GLOXIOU/DMX-Unit-DIY/3D-files/to print/Unite DMX - Assembly.step

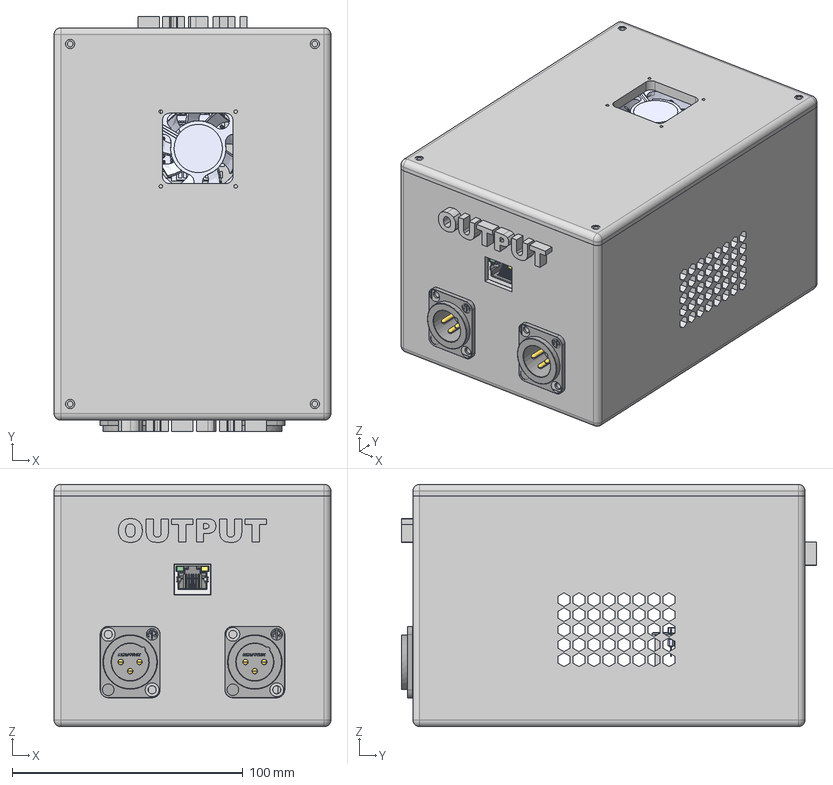
[picture p7: CAD file, 2026-09-11]
3D-files/to print/Unite DMX - Assembly.step
120.0 x 180.0 x 105.0 mm
