GLOXIOU/DMX-Unit-DIY/3D-files/tiny-version/NC3MD-LX_01-GC-STEP.stp

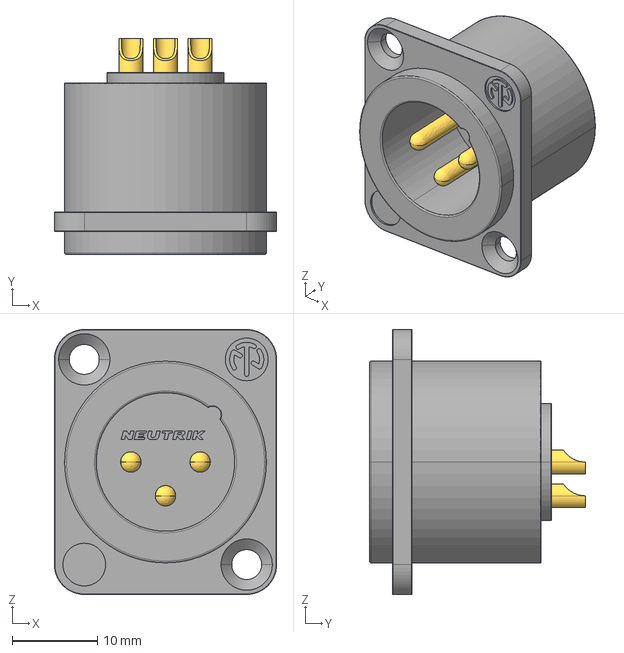
[picture p9: CAD file, 2026-09-11]
3D-files/tiny-version/NC3MD-LX_01-GC-STEP.stp
26.0 x 25.3 x 31.0 mm
