GLOXIOU/DMX-Unit-DIY/3D-files/tiny-version/to print/DMX Unit Tiny - Base.stl

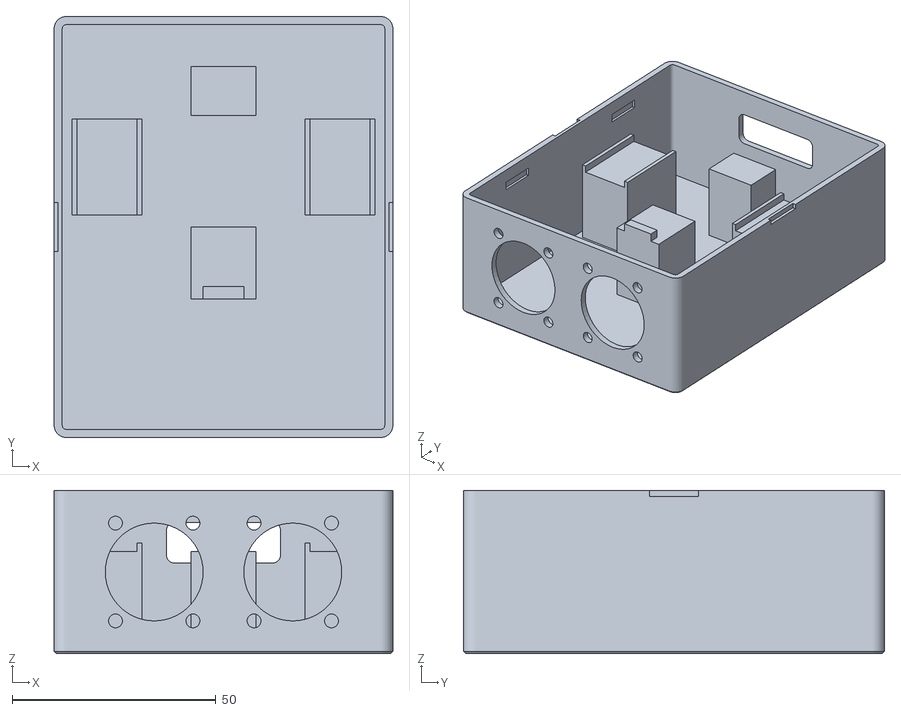
[picture p10: CAD file, 2026-11-05]
3D-files/tiny-version/to print/DMX Unit Tiny - Base.stl
83.1 x 103.3 x 40.0
