GLOXIOU/DMX-Unit-DIY/3D-files/assembly/40x40 Cooling Fan.STEP

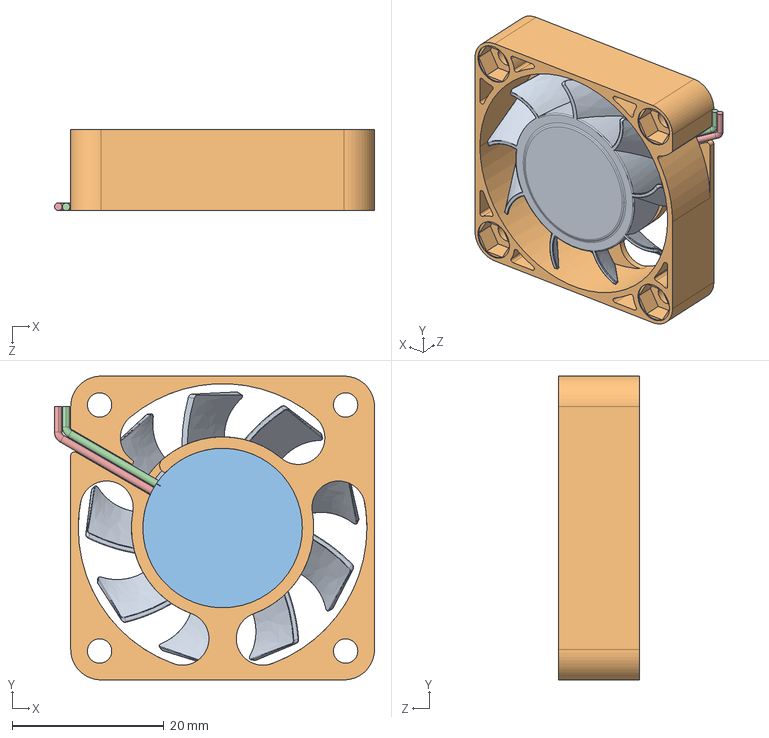
[picture p11: CAD file, 2026-09-11]
3D-files/assembly/40x40 Cooling Fan.STEP
42.1 x 40.0 x 10.7 mm
