GLOXIOU/DMX-Unit-DIY/3D-files/Lite_w5500.step

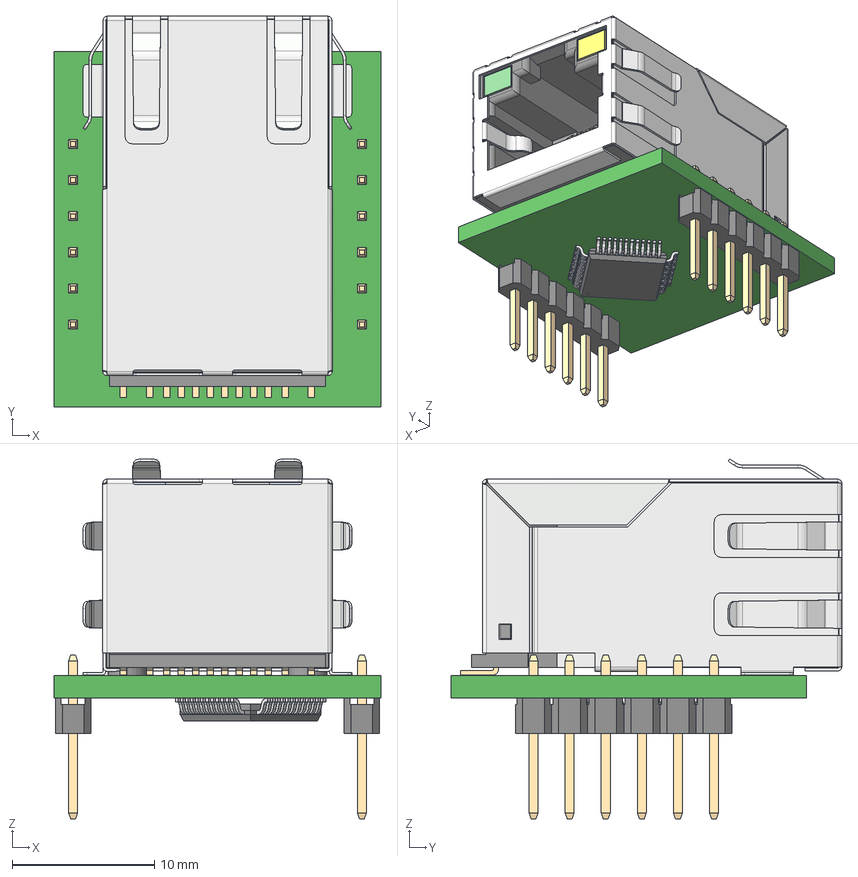
[picture p12: CAD file, 2026-09-11]
3D-files/Lite_w5500.step
23.0 x 27.5 x 25.3 mm
Board
48LQFP_W5500_WIZ
PH1-06-UA x 2
2pin-LED_1_1
P-﹗+L-7Pin-AA
P-﹗+L-5Pin-AA
led1
1X1RJ45-housing_-ｦL｡
