GLOXIOU/DMX-Unit-DIY/3D-files/tiny-version/to print/DMX Unit Tiny - Lid.stl

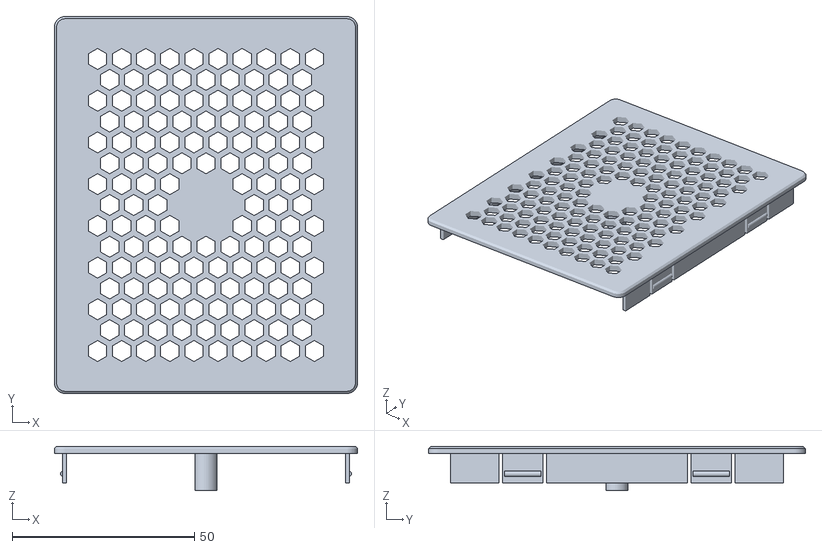
[picture p13: CAD file, 2026-11-05]
3D-files/tiny-version/to print/DMX Unit Tiny - Lid.stl
83.1 x 103.3 x 12.1
