GLOXIOU/DMX-Unit-DIY/3D-files/to print/DMX Unit - V4 - F.stl

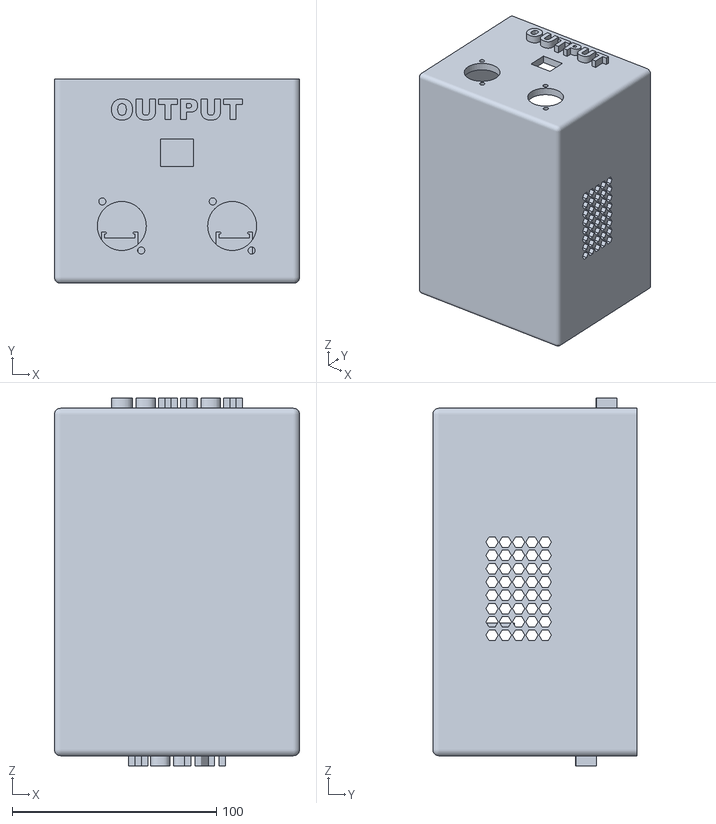
[picture p14: CAD file, 2026-09-11]
3D-files/to print/DMX Unit - V4 - F.stl
120.0 x 100.0 x 180.0
