GLOXIOU/DMX-Unit-DIY/3D-files/to print/DMX Unit - Cover - F.stl

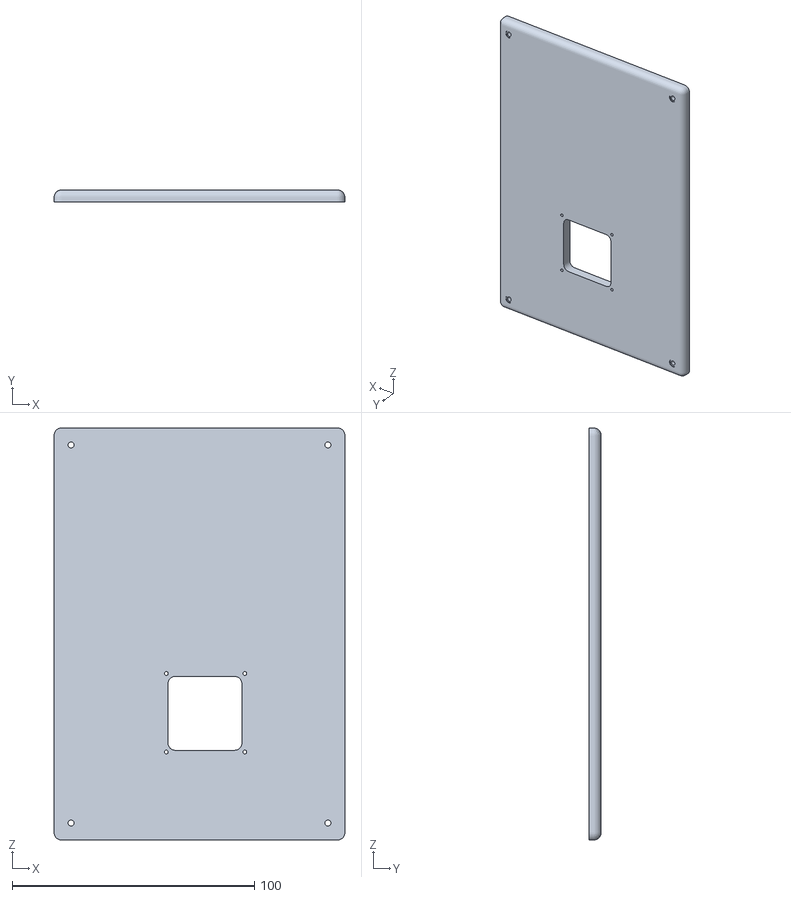
[picture p15: CAD file, 2026-09-11]
3D-files/to print/DMX Unit - Cover - F.stl
120.0 x 5.00 x 170.0
