GLOXIOU/DMX-Unit-DIY/3D-files/DMX Unit - V3.stl

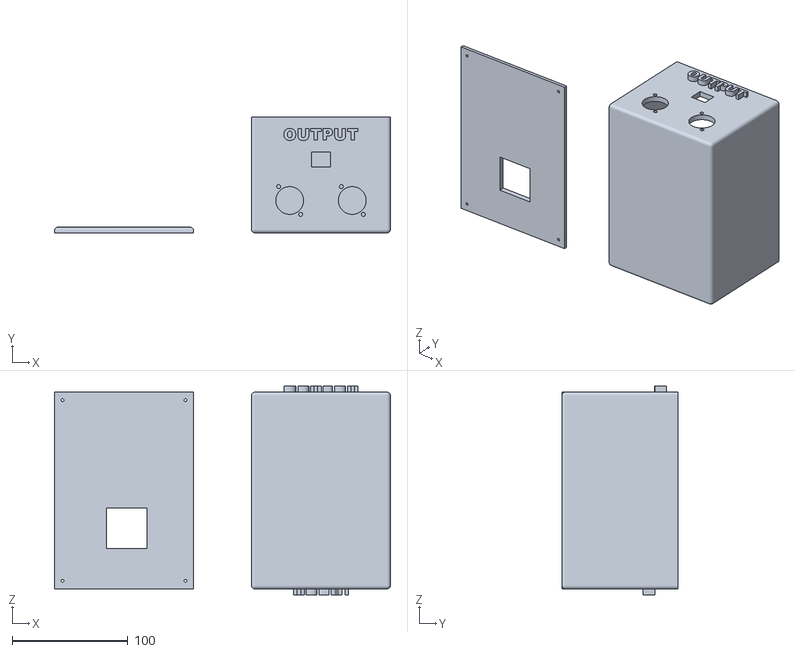
[picture p16: CAD file, 2026-09-11]
3D-files/DMX Unit - V3.stl
290.0 x 100.0 x 180.0
