GLOXIOU/DMX-Unit-DIY/(list of files, cad)

Other CAD files:
3D-files/DMX Unit - V2.stl
3D-files/DMX Unit - Cover.f3d
3D-files/DMX Unit - V1.stl
3D-files/DMX Unit.f3d
3D-files/assembly/DMX Unit up.f3d
3D-files/assembly/DMX Unit.f3d
3D-files/assembly/ass Unite DMX.f3z
3D-files/tiny-version/DMX Unit Tiny.f3d
3D-files/tiny-version/MAX RS 485 module v2.f3d
