GLOXIOU/DMX-Unit-DIY/JOURNAL.md

| title | DMX-Unit-DIY |
| --- | --- |
| author | GLOXIOU |
| description | A DIY project for a DMX controller box that enables stable lighting control via Wi-Fi or USB, featuring both Art-Net and DMX outputs. |
| created_at | 2026-09-08 |

# Day 1: Defining system & idea search & inspiration

I want to make a DMX Box, with WiFi and USB input, and DMX and ArtNet output. All of that in a small box, designed in 3D in Fusion 360. Everything will be managed by an ESP32, and cooled by a 40x40 tiny little fan.

My inspiration is the Enttec Open DMX USB Interface. I want to make that, but for much cheaper, and with more functionality. The only thing I want to keep from that housing is his formfactor, a very small box.

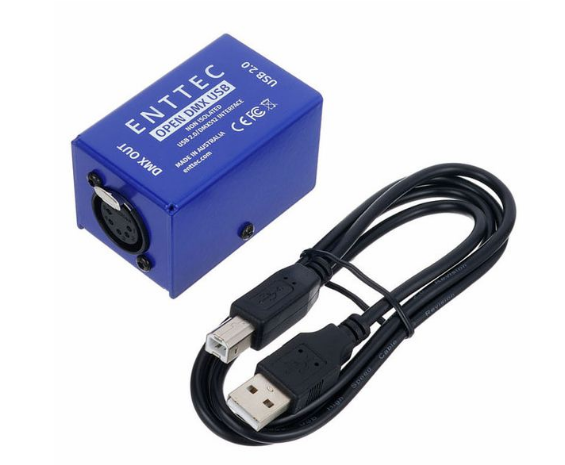
[picture p17: images/img-1.png]


So, here is an initial list of the equipment needed for the project which, of course, is still subject to change:

| Component | Quantity | Price |
| --- | --- | --- |
| [W5500](https://fr.aliexpress.com/item/1005007639330460.html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) | 1 | 6,27$ |
| [MAX485 RS-485 Module](https://fr.aliexpress.com/item/1005007894242423.html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) | 2 | 3,26$ |
| [ESP32-S3](https://fr.aliexpress.com/item/1005008809316571.html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) | 1 | 3,95$ |
| [XLR 3-Pin Panel Mount Female](https://fr.aliexpress.com/item/1005008919369057.html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) | 2 | 4,88$ |
| [12-Hole Bridge](https://fr.aliexpress.com/item/1005006003920533.html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) | 2 | 0,81$x2 |
| [Dupont cables](https://www.aliexpress.com/ssr/300000512/BundleDealsDutyCovered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) | kit | 2,48$ |
| **Total** | | **22,46$** |

I then drew the wiring diagram showing the connections between the components. Here is what I’ve managed to put together, but just like the list of components it’s still subject to change. Here is it:

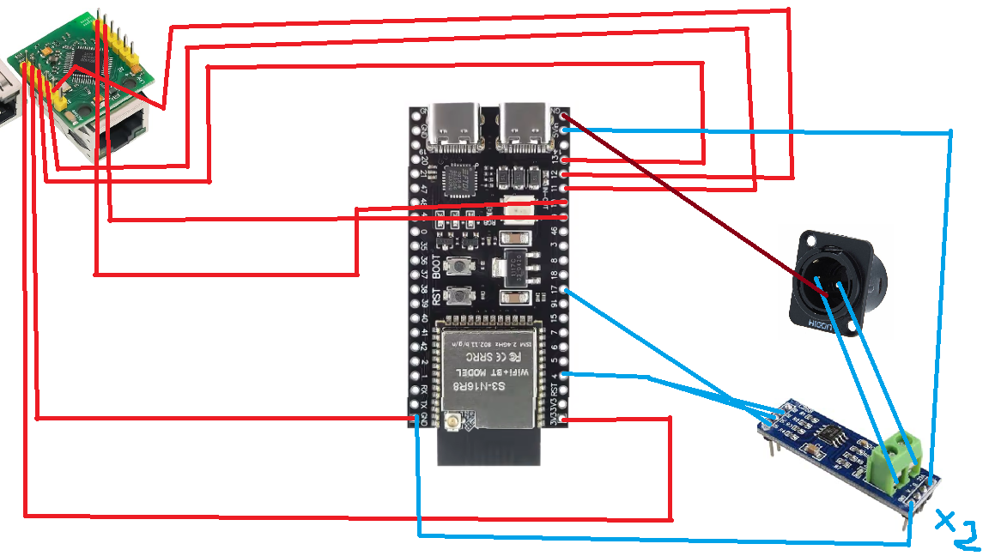
[picture p18: images/schema-1.png]
Schema 1


And the summary table:

**ESP32-S3 (S3-N16R8)**

| ESP32-S3 Pin | Connected Component | Component Pin |
| :--- | :--- | :--- |
| **3V3** | W5500 Mini | 3.3V (J1, Pin 1) |
| **GND** | W5500 Mini / MAX485 #1 / MAX485 #2 / XLR #1 / XLR #2 | GND / Pin 1 (XLR) |
| **5Vin** | MAX485 #1 / MAX485 #2 | VCC |
| **GPIO 4** | MAX485 #1 | DE + RE (tied together) |
| **GPIO 5** | MAX485 #2 | DE + RE (tied together) |
| **GPIO 9** | W5500 Mini | RST (J2, Pin 2) |
| **GPIO 10** | W5500 Mini | SCS / CS (J2, Pin 1) |
| **GPIO 11** | W5500 Mini | MOSI (J1, Pin 4) |
| **GPIO 12** | W5500 Mini | SCLK (J1, Pin 5) |
| **GPIO 13** | W5500 Mini | MISO (J1, Pin 3) |
| **GPIO 17** | MAX485 #1 | DI |
| **GPIO 18** | MAX485 #2 | DI |

**W5500 Mini (Top view, RJ45 facing down)**

| Row | Pin | Signal | ESP32-S3 Connection |
| :--- | :--- | :--- | :--- |
| **Left (J1)** | 1 (Top) | **3.3V** | **3V3** |
| **Left (J1)** | 2 | **GND** | **GND** |
| **Left (J1)** | 3 | **MISO** | **GPIO 13** |
| **Left (J1)** | 4 | **MOSI** | **GPIO 11** |
| **Left (J1)** | 5 (Bottom) | **SCLK** | **GPIO 12** |
| **Right (J2)** | 1 (Top) | **SCS** | **GPIO 10** |
| **Right (J2)** | 2 | **RST** | **GPIO 9** |
| **Right (J2)** | 3 | **INT** | *Not connected* |
| **Right (J2)** | 4 | **NC** | *Not connected* |
| **Right (J2)** | 5 (Bottom) | **NC** | *Not connected* |

**MAX485 Module #1 (DMX Universe 1)**

| MAX485 #1 Pin | Connection |
| :--- | :--- |
| **VCC** | **5Vin** (ESP32-S3) |
| **GND** | **GND** (ESP32-S3) + Pin 1 (XLR #1) |
| **DI** | **GPIO 17** (ESP32-S3) |
| **RO** | *Not connected* |
| **DE** | **GPIO 4** (ESP32-S3) |
| **RE** | **GPIO 4** (ESP32-S3, tied with DE) |
| **A** | Pin 3 / DMX+ (XLR #1) |
| **B** | Pin 2 / DMX- (XLR #1) |

**MAX485 Module #2 (DMX Universe 2)**

| MAX485 #2 Pin | Connection |
| :--- | :--- |
| **VCC** | **5Vin** (ESP32-S3) |
| **GND** | **GND** (ESP32-S3) + Pin 1 (XLR #2) |
| **DI** | **GPIO 18** (ESP32-S3) |
| **RO** | *Not connected* |
| **DE** | **GPIO 5** (ESP32-S3) |
| **RE** | **GPIO 5** (ESP32-S3, tied with DE) |
| **A** | Pin 3 / DMX+ (XLR #2) |
| **B** | Pin 2 / DMX- (XLR #2) |

**3-Pin XLR Connectors**

| XLR Connector | XLR Pin | Connection |
| :--- | :--- | :--- |
| **XLR #1 (Universe 1)** | Pin 1 (Shield) | **GND** |
| **XLR #1 (Universe 1)** | Pin 2 (Data -) | **B** (MAX485 #1) |
| **XLR #1 (Universe 1)** | Pin 3 (Data +) | **A** (MAX485 #1) |
| **XLR #2 (Universe 2)** | Pin 1 (Shield) | **GND** |
| **XLR #2 (Universe 2)** | Pin 2 (Data -) | **B** (MAX485 #2) |
| **XLR #2 (Universe 2)** | Pin 3 (Data +) | **A** (MAX485 #2) |

**Total time spent: 3 hours**

# Day 2: 3D conception and other stuff

I want to make a small box, the smalest possible with all of the componment. That box will be print in PLA, on a Bambulab A1. So the maximum size is 25,6cm by 25,6cm. This enclosure must therefore house a small 40x40mm fan, two XLR ports and the necessary circuitry to operate them, an Art-Net port and the necessary circuitry to operate it, as well as a USB-C port—already integrated into the ESP32, which must also be inside the enclosure.

I'm now making the box on Fusion 360, with the dimension of the componment. Here's what it's look like: (You can check the V1 file [just here](3D-files/DMX%20Unit%20-%20V1.stl).)

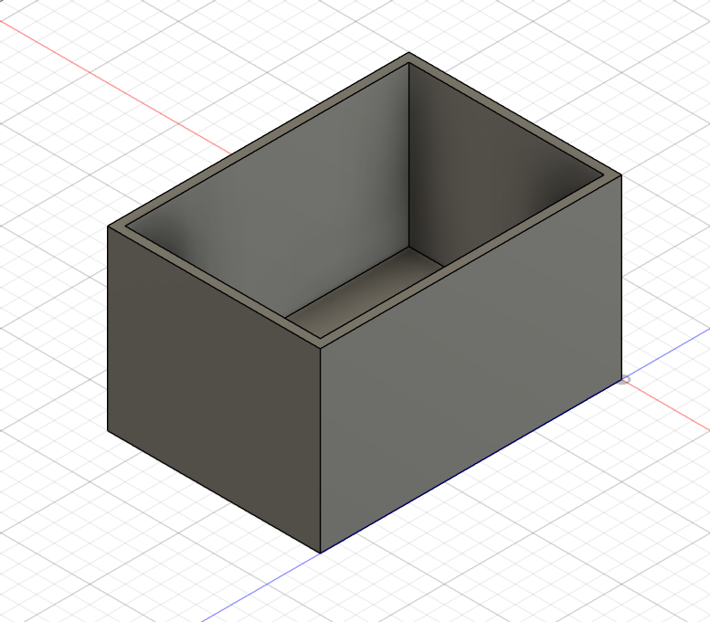
[picture p19: images/img-2.png]
First version


An XLR connector is 1.6 cm wide. We have 2, and between those two centres, there is a 6 cm gap . On top of that, there is a 3 cm gap  between the outer edges (right and left) and the centres of the XLR connectors. Adding all that up, you end up with a box that is 12 cm wide . It fits on the Bambu Lab A1 build plate.

As for the length, the ESP-32 is 5,5cm long, and the MAX485 is 4,5. The Ethernet module is litlle, and don't need to be add to the calculation. But, there's the the length of the XLR connectors, and the addition of extra space to make assembly easier. So the box will be 17cm.

Regarding the height of the box, the main consideration is ease of construction. The box will therefore be 10 cm high.

So, to sum up, the box measures 12x17x10. It fits perfectly on the Bambu Lab A1 build plate! I think I'm going to spend a lot of time on 3D, simply because I'm just starting out with modeling.

Regarding airflow, I decided to mount the 40x40mm fan inside the enclosure—on the lid, directly above the ESP-32—to improve cooling and save space. Near the bottom, along the two 17cm-long sides, there will be a grille of some sort to allow air to exit the box. Even though hot air rises, my experience has taught me that it is better to direct the airflow straight onto the ESP to cool it down.

To close the box, I am going to install heat-set threaded inserts that will allow the lid to be screwed on.

Here is a list of items to buy for the box, other than the electronic components:

| Components | Quantity | Price |
| --- | --- | --- |
| [heat-set threaded inserts](https://fr.aliexpress.com/item/1005007640664497.html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) | 4 | 1,86$ |
| [M2 metric screws](https://fr.aliexpress.com/item/32810852732.html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) | 4 | 1,54$ |
| [40x40mm fan](https://fr.aliexpress.com/item/1005006212685458.html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) | 1 | 3,21$ |
| [2N2222 Transistor](https://fr.aliexpress.com/item/1005010473134376.html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) | 1 | 1,55$ |
| [1 kΩ resistor](https://fr.aliexpress.com/item/1005007010335100.html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) | 1 | 1,59$ |

To run the fan, you need to add a 2N2222 transistor and a 1 kΩ resistor. So, I need to updated the ESP-32 wiring diagram with all that. I also need to changes the 3D model, with the cover and all the wholes.

**Total time spent: 3.5 hours**

# Day 3: Continue the 3D model and the ESP-32 wiring diagram

I started by updating the 3D model: (You can check the V2 file [just here](3D-files/DMX%20Unit%20-%20V2.stl).)

Here are the cotations for the output pannel, in the front of the box:

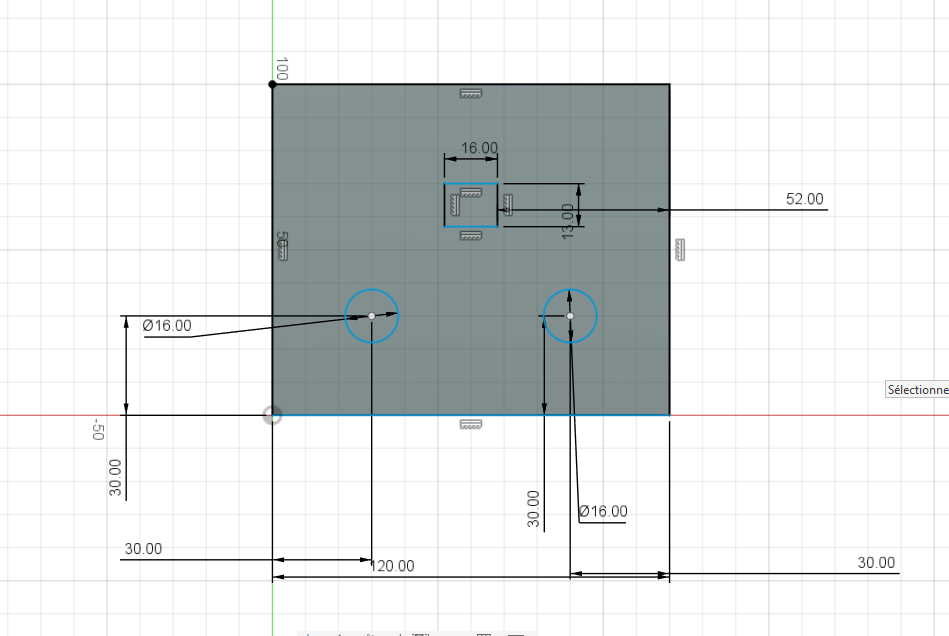
[picture p20: images/img-4.png]


And it's 3D version (with a litlle text):

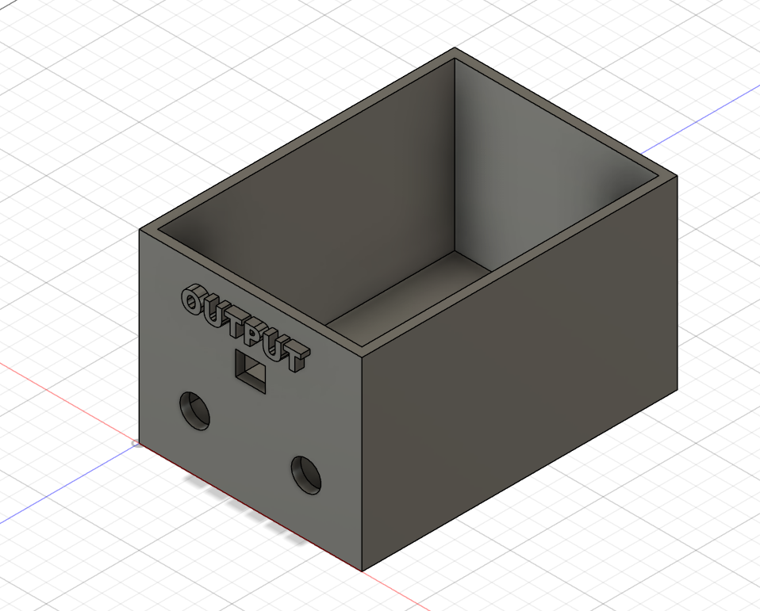
[picture p21: images/img-5.png]


That is the back pannel, with just the hole for the ESP32-S3 (I made it generously sized for ease of use):

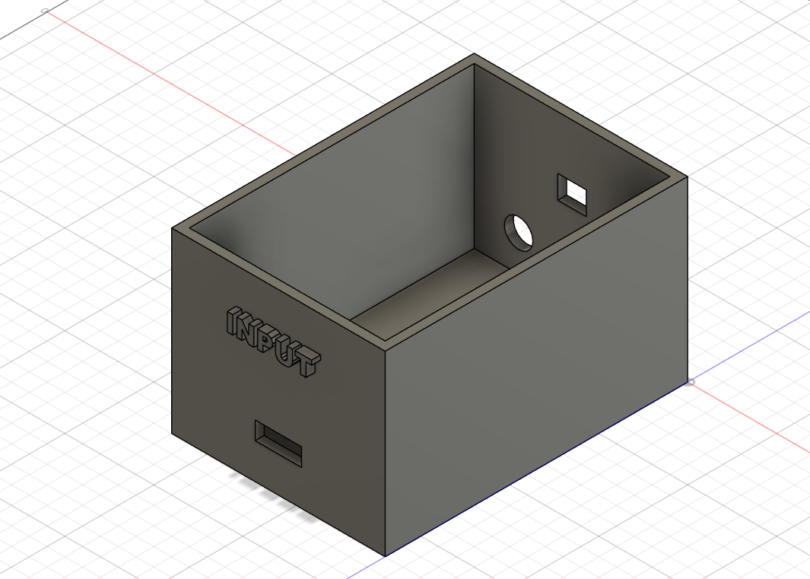
[picture p22: images/img-6.png]
Back pannel


I’ve also made a lid. All that’s left is to make the mounts for the components and the lid itself. I also need to make the ventilation grilles on both sides, but that's very simple to do. I apologize for the quality of the 3D models, I hate modeling, so I kept it as simple as possible so I could spend time on what I enjoy more !

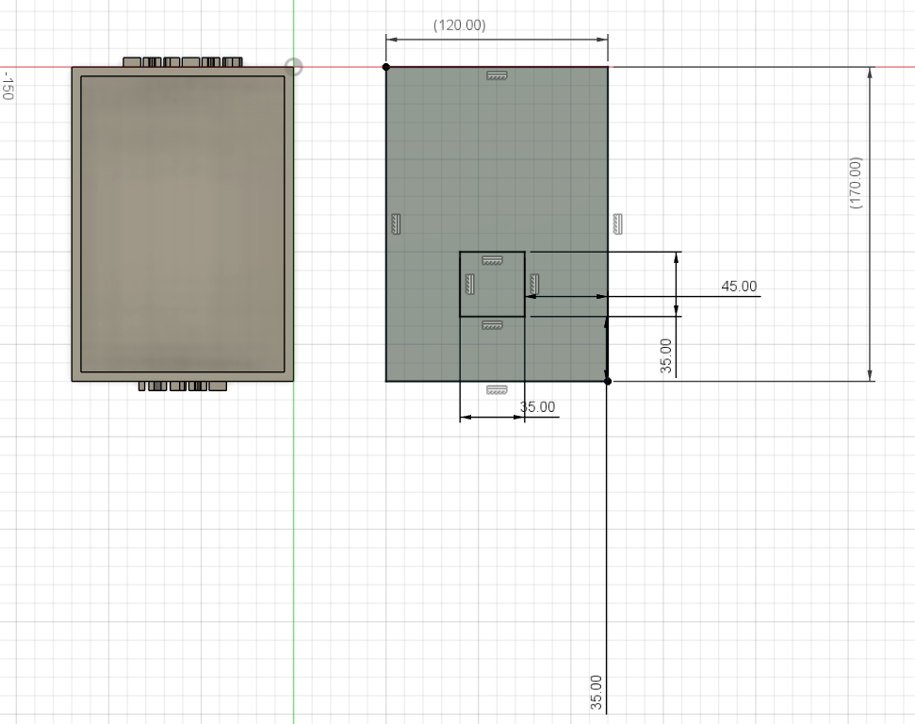
[picture p23: images/img-7.png]
The lid


To secure the components, I would use cable ties with the mounts I've made, and for the fan, glue will do the trick.

And the I finished the wiring diagram, wich normally is the final version:

Final schema

Please excuse the state of the wiring diagram. I had to create it on an iPad, which isn't very convenient. That’s why I’m making a connection chart to help me keep track of things when assembling the components. So I also updated the connection chart, so here is it:

ESP32-S3 (S3-N16R8)

ESP32-S3 Pin | Connected Component | Component Pin
--- | --- | ---
3V3 | W5500 Mini | 3.3V (J1, Pin 1)
GND | W5500 Mini / MAX485 #1 / MAX485 #2 / XLR #1 / XLR #2 / 2N2222 | GND / Pin 1 (XLR) / Emitter
5Vin | MAX485 #1 / MAX485 #2 / Fan | VCC / VCC / Fan +
GPIO 4 | MAX485 #1 | DE + RE (tied together)
GPIO 5 | MAX485 #2 | DE + RE (tied together)
GPIO 6 | Fan circuit | 1kΩ resistor → Base 2N2222
GPIO 9 | W5500 Mini | RST (J2, Pin 2)
GPIO 10 | W5500 Mini | SCS / CS (J2, Pin 1)
GPIO 11 | W5500 Mini | MOSI (J1, Pin 4)
GPIO 12 | W5500 Mini | SCLK (J1, Pin 5)
GPIO 13 | W5500 Mini | MISO (J1, Pin 3)
GPIO 17 | MAX485 #1 | DI
GPIO 18 | MAX485 #2 | DI

W5500 Mini (Top view, RJ45 facing down)

Row | Pin | Signal | ESP32-S3 Connection
--- | --- | --- | ---
Left (J1) | 1 (Top) | 3.3V | 3V3
Left (J1) | 2 | GND | GND
Left (J1) | 3 | MISO | GPIO 13
Left (J1) | 4 | MOSI | GPIO 11
Left (J1) | 5 (Bottom) | SCLK | GPIO 12
Right (J2) | 1 (Top) | SCS | GPIO 10
Right (J2) | 2 | RST | GPIO 9
Right (J2) | 3 | INT | Not connected
Right (J2) | 4 | NC | Not connected
Right (J2) | 5 (Bottom) | NC | Not connected

MAX485 Module #1 (DMX Universe 1)

MAX485 #1 Pin | Connection
--- | ---
VCC | 5Vin (ESP32-S3)
GND | GND (ESP32-S3) + Pin 1 (XLR #1)
DI | GPIO 17 (ESP32-S3)
RO | Not connected
DE | GPIO 4 (ESP32-S3)
RE | GPIO 4 (ESP32-S3, tied with DE)
A | Pin 3 / DMX+ (XLR #1)
B | Pin 2 / DMX- (XLR #1)

MAX485 Module #2 (DMX Universe 2)

MAX485 #2 Pin | Connection
--- | ---
VCC | 5Vin (ESP32-S3)
GND | GND (ESP32-S3) + Pin 1 (XLR #2)
DI | GPIO 18 (ESP32-S3)
RO | Not connected
DE | GPIO 5 (ESP32-S3)
RE | GPIO 5 (ESP32-S3, tied with DE)
A | Pin 3 / DMX+ (XLR #2)
B | Pin 2 / DMX- (XLR #2)

3-Pin XLR Connectors

XLR Connector | XLR Pin | Connection
--- | --- | ---
XLR #1 (Universe 1) | Pin 1 (Shield) | GND
XLR #1 (Universe 1) | Pin 2 (Data -) | B (MAX485 #1)
XLR #1 (Universe 1) | Pin 3 (Data +) | A (MAX485 #1)
XLR #2 (Universe 2) | Pin 1 (Shield) | GND
XLR #2 (Universe 2) | Pin 2 (Data -) | B (MAX485 #2)
XLR #2 (Universe 2) | Pin 3 (Data +) | A (MAX485 #2)

Fan 40x40mm

| Fan Pin | Connection | 
| --- | --- |
| + | 5Vin (ESP32-S3) |
| - | Collector (2N2222) |

2N2222

2N2222 Pin | Connection
--- | ---
Base | GPIO 6 through 1kΩ resistor
Collector | Fan -
Emitter | GND

The RJ45 connector is tricky because, since it's the mini version, the port labels aren't printed on the PCB. So, I asked an LLM about the pinout.

Now that I've done that, all that's left is to finish the 3D model, write the full code, and create the readme. I think the modeling will take the longest. I also need to put together the complete BOM, including all prices and links.

**Total time spent: 5 hours**

# Day 4: 3D modeling, again...

I started by making the edge of the box curved, beacause aparently it's a requirment in HackClub, so here it is:

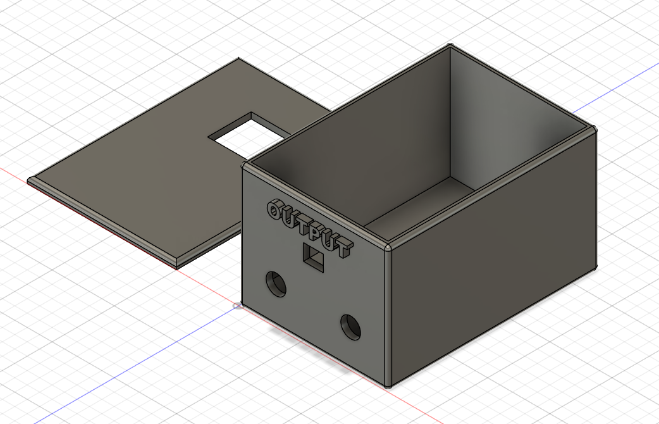
[picture p24: images/img-8.png]
Curved edge


And, like other days, you can check the V3 file [just here](3D-files/DMX%20Unit%20-%20V3.stl).

Then I realized I'd made a mistake with the XLR output size. So I drilled another hole fot that, and for the screws.

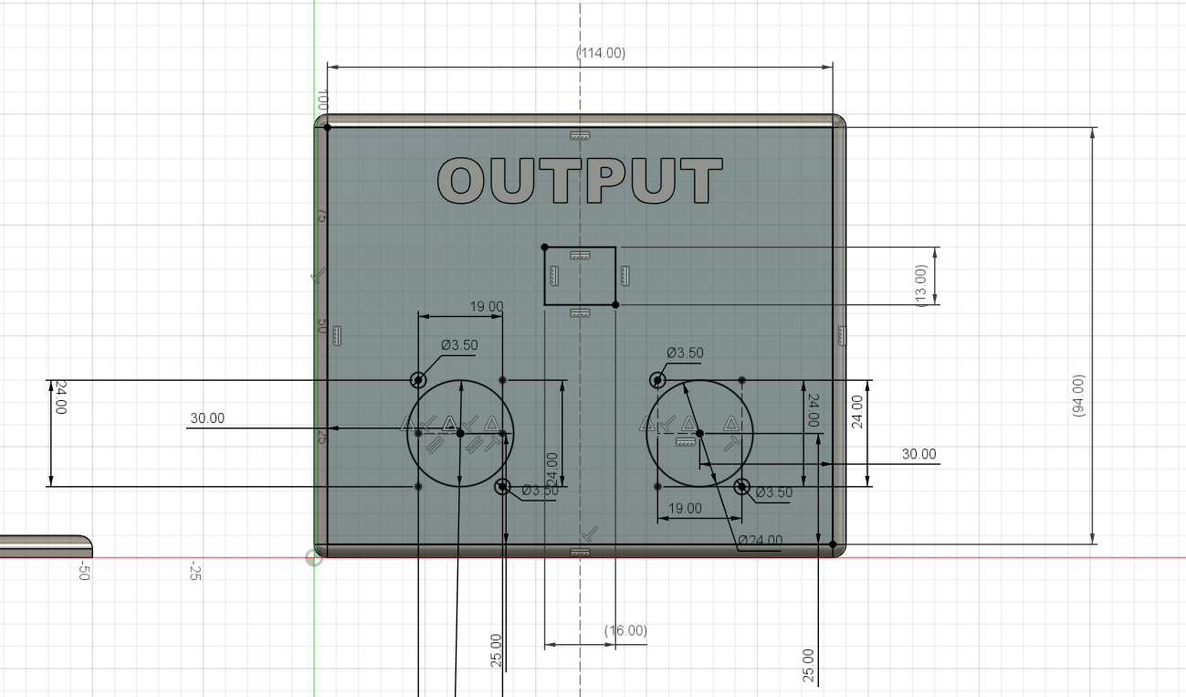
[picture p25: images/img-9.png]
XLR Hole

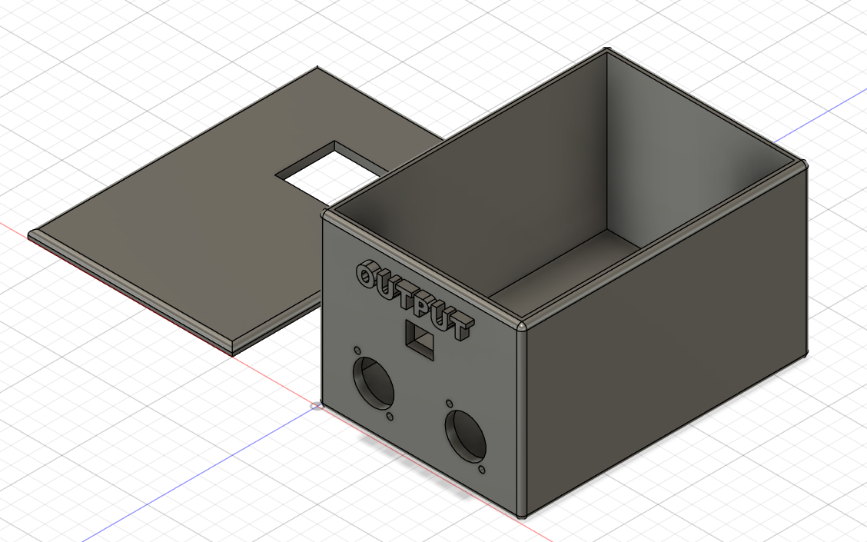
[picture p26: images/img-10.png]
The 3D version


After that, I made the supports and the woles for the cover of the box. All that remains are the mounts for the components !

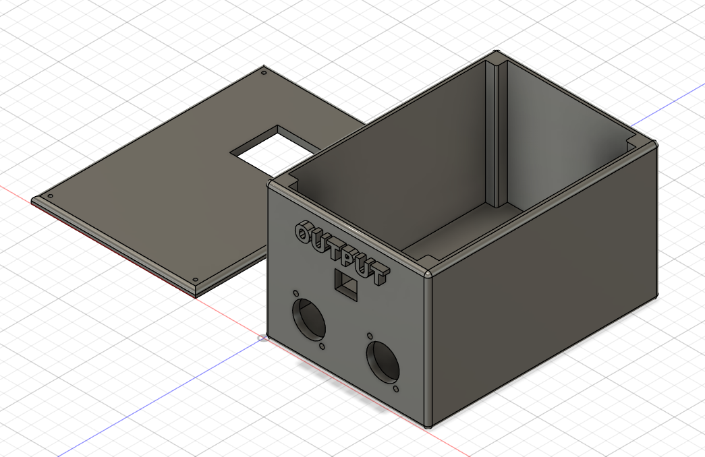
[picture p27: images/img-11.png]
Woles for the cover


When I come back this afternoon, I search all the components on [grabcad](grabcad.com), download it, place it. You can check all the models I dowload in [this folder](3D-files/).

And I made the support for the components. I also delete the curve edge that I made on the top of the box, beacause thre is already one on the cover. The componment are also integreted, the assembly is also complete. So here's how the 3D model look so far:

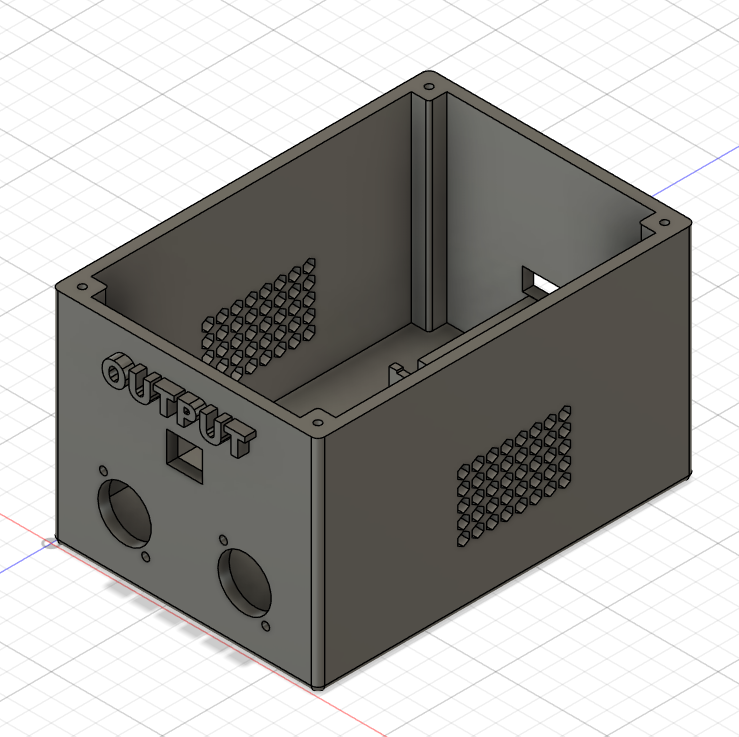
[picture p28: images/img-12.png]
Final look


And there is the final 3D file [just here](3D-files/DMX%20Unit%20-%20V4%20-%20F.stl) !

Here are several screenshots of the model and the assembly:


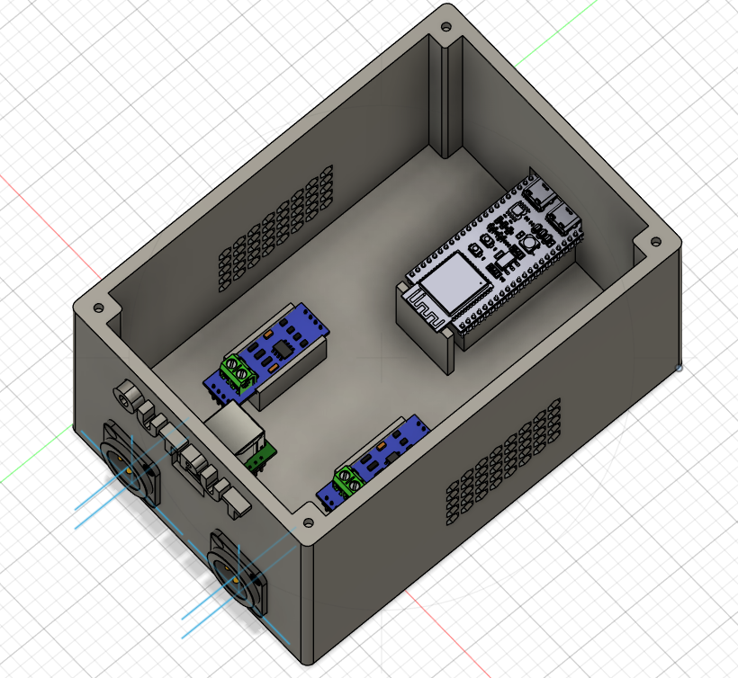
[picture p29: images/img-14.png]



You can check all the final stl 3D files in [this folder](3D-files/to%20print/); the assembly files in [that folder](3D-files/assembly/) and the ultimate step assembly file [just here](3D-files/assembly/Unite%20DMX%20-%20Assembly.step)

Today was so much modeling, and I learn so much things ! To sum up, all the mounts are done including the one for the cover the components are in the right places, and the airflow is optimized. I think the case is really great !

**Total time spent: 5 hours**

# Day 5: BOM and begening of the code

I started the day by doing the BOM of the project using the tables I had already made on previous days: (You can check the CSV file [here](BOM.csv))

| Component | Quantity | Price |
| --- | ---: | ---: |
| [W5500](https://fr.aliexpress.com/item/1005007639330460.html) | 1 | $6.27 |
| [MAX485 RS-485 Module](https://fr.aliexpress.com/item/1005008477779481.html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) | 2 | 2x$1 |
| [ESP32-S3](https://fr.aliexpress.com/item/1005008809316571.html) | 1 | $3.95 |
| [XLR 3-Pin Panel Mount Female](https://fr.aliexpress.com/item/1005008919369057.html) | 2 | $4.88 |
| [Dupont Cables](https://www.aliexpress.com/ssr/300000512/BundleDealsDutyCovered) | 1 kit | $2.48 |
| [Heat-Set Threaded Inserts](https://fr.aliexpress.com/item/1005007640664497.html) | 4 | $1.86 |
| [M2 Metric Screws](https://fr.aliexpress.com/item/32810852732.html) | 4 | $1.54 |
| [40 × 40 mm Fan](https://fr.aliexpress.com/item/1005006212685458.html) | 1 | $3.21 |
| [2N2222 Transistor](https://fr.aliexpress.com/item/1005010473134376.html) | 1 | $1.55 |
| [1 kΩ Resistor](https://fr.aliexpress.com/item/1005007010335100.html) | 1 | $1.59 |
| **Total** | | **$29,33** |

The chart didn't take me a huge amount of time, but I also verified the compatibility of all the components, the circuit diagram, as well as prices, links, quantities, and so on, just to be sure, since the project is nearing completion.

Next, I worked on the firmware. I would say about half the features are ready. It still needs testing, and most importantly, I need to go through this entire list:

* DMX/USB input ("Enttec-like" mode when connecting the ESP32-S3 via USB).
* Wi-Fi mode / configuration portal.
* **ArtPoll** response (the device will not automatically appear in
Art-Net discovery software — the IP address must be entered manually;
`192.168.1.77` by default in this sketch).
* Persistent settings storage (Preferences/EEPROM).
* RDM.

So there's still a little bit of work to do ! You can check the file V1 [just here](firvware%20-%20V1). Here is a look at the code:

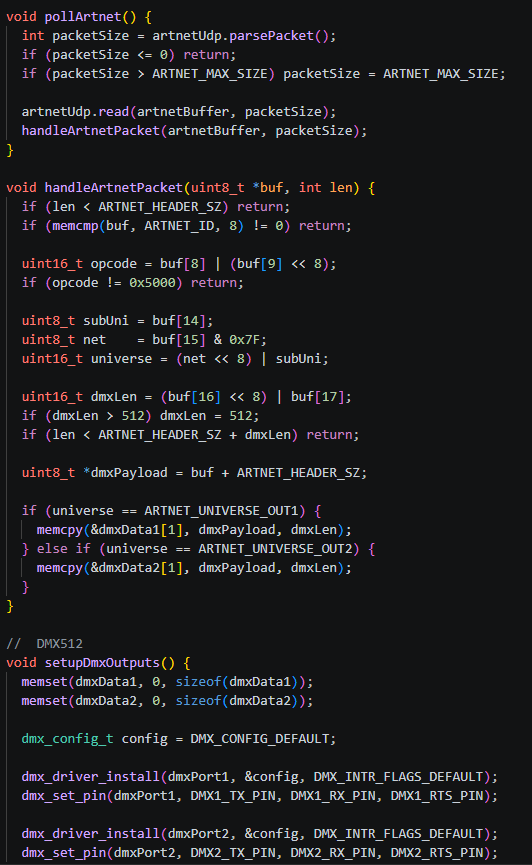
[picture p30: images/img-16.png]
Part of the code


**Total time spent: 3 hours**

# Day 6: Finishing + testing the code

I started the day by finishing writing the intire code. You can see the file [here](firvware%20-%20V2).

Everything that was in the TO-DO list of yesterday is done. All that's left is to test it, even though I don't have the physical hardware to do so. The code is solid, so I'm a bit concerned about stability ! Worst case scenario, I'll modify the code later.

The most time consuming part was building the web interface, as it was my first time creating one for an ESP-32. This interface allows you to:

* Configure network settings, addresses, etc.
* Configure Wi-Fi (SSID and password)
* Set up Art-Net, assign DMX universes, etc.
* Adjust hardware settings, configure the fan, and set up USB or Wi-Fi inputs
* Scan the DMX network and perform RDM detection

If everything works, it’s going to be really great !

However, for the code to work, it is necessary that the "USB CDC On Boot" parameter is enabeld, and that all these libraries be installed:

* esp_dmx by Mitch Weisbrod (in the lastest version)
* Ethernet (arduino-libraries/Ethernet)
* WiFi, WebServer, DNSServer, Preferences (but that come pre-installed on the board, so that's okay)

I haven't compiled the final version of the code yet, so I'm going to do that to see if everything works. To do that, I'm using [wokwi](wokwi.com), and select ESP32-S3 template.

The first time that I compiled, I had this message: 
```cpp
sketch.ino: In function 'void setupFan()':

sketch.ino:264:3: error: 'ledcSetup' was not declared in this scope

264 | ledcSetup(FAN_PWM_CHANNEL, FAN_PWM_FREQ, FAN_PWM_RES);

| ^~~~~~~~~

sketch.ino:265:3: error: 'ledcAttachPin' was not declared in this scope; did you mean 'ledcAttach'?

265 | ledcAttachPin(FAN_PIN, FAN_PWM_CHANNEL);

| ^~~~~~~~~~~~~

| ledcAttach

Error during build: exit status 1
```

So I modified the code at line 262 by that: 
```cpp
// Fan
void setupFan() {
  ledcAttach(FAN_PIN, FAN_PWM_FREQ, FAN_PWM_RES);
  applyFanDuty(cfg.fanDuty);
}

void applyFanDuty(uint8_t duty) {
  ledcWrite(FAN_PIN, duty);
}
```

It was just a litlle Fan problem, but then I had a bigger problem with my DMX fonction. It was a pretty big bug, so I spent a lot of time on it. There was a version issue with the DMX package... I deleted the librairy and just use the native series port, on the advice of an LLM. After sorting that out, it work !! (I had to make some other litlle changes tho) Here's a proof:

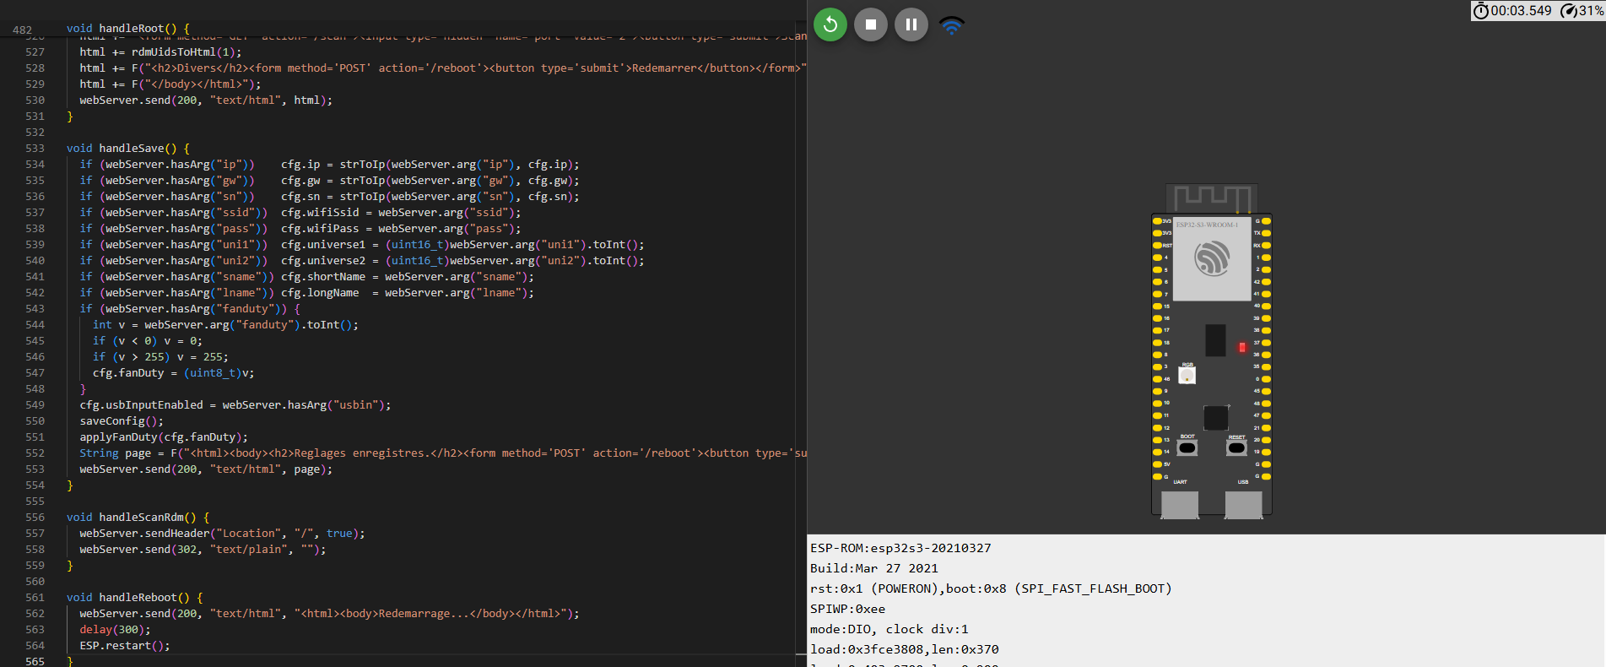
[picture p31: images/img-17.png]


It was a lot of work... Check those screenshot:

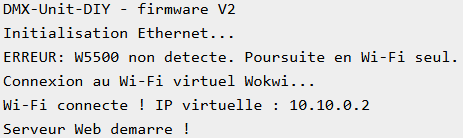
[picture p32: images/img-18.png]

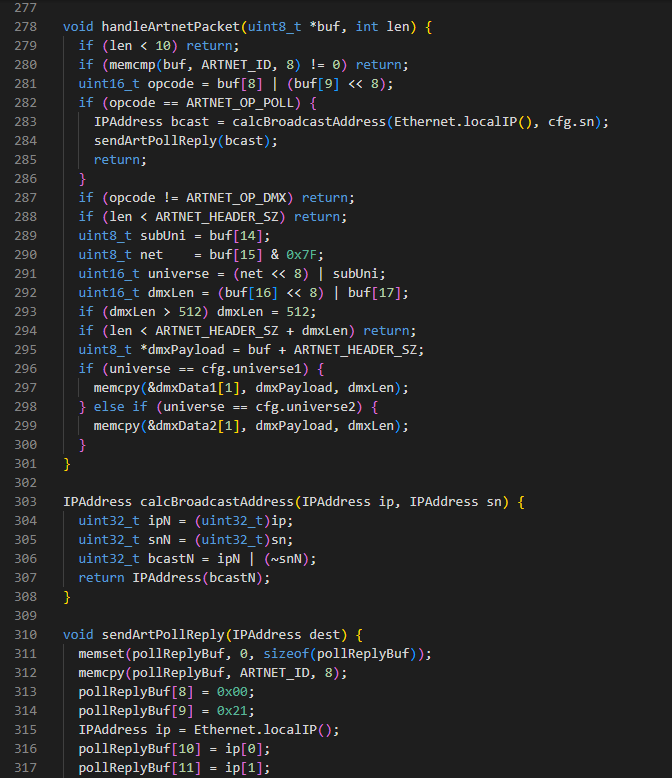
[picture p33: images/img-19.png]


Now, I just need the physical equipment to test... Tomorow, I will send the project if everything is okay. I just need to do the README file.

**Total time spent: 3.5 hours**

# Day 7: README and verification

Today is the last day, this night I'm gonna publish the project.

I just need to do the README and verified the entire project (schema, BOM, connection, code, etc.), so The documentation isn't going to be very long.

I started by creating the README, while also looking at the repositories of people whose projects had already been accepted. This helped me avoid mistakes even in the rest of the project by observing the kind of feedback the Hack Club team typically gives.

After that, I checked absolutely everything line by line, image by image, and code block by code block (it took a long time !).

I also updated the firmware file with some comments to understand the code easely.

I need to put a picture in the journal day, so here it is, a screenshot of the README on github:

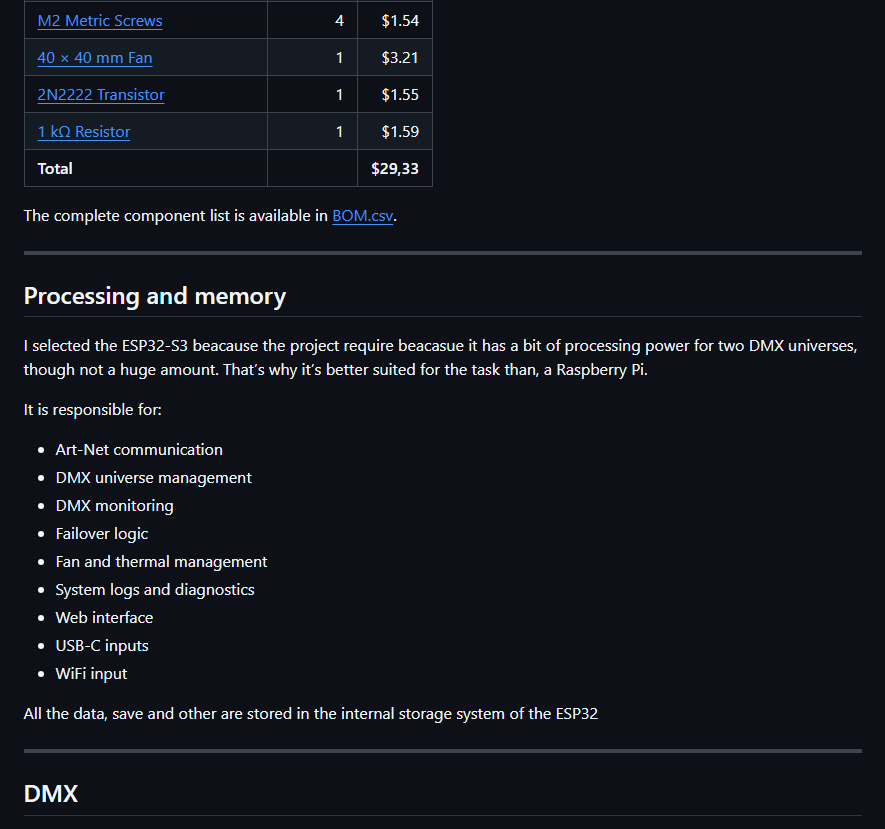
[picture p34: images/img-20.png]
README


**Total time spent: 3 hours**

# Day 8: Tiny version

Hey !

So today I wand to make a tiny version of the box, with just the 2 outputs, not the Ethernet, not the fan. I will do it even if the project has already been accepted, and it's why I will not much argue and detail on what I do.

Most of the part is just on the 3D files...

So I created a completly new box, here it is:





That you can dowload in [this](3D-files/tiny-version/) folder if you want. I also put the new BOM with just the needed componments here:

| Component | Quantity | Price |
| --- | ---: | ---: |
| [MAX485 RS-485 Module](https://fr.aliexpress.com/item/1005008477779481.html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) | 2 | 2x$1 |
| [ESP32-S3](https://fr.aliexpress.com/item/1005008809316571.html) | 1 | $3.95 |
| [XLR 3-Pin Panel Mount Female](https://fr.aliexpress.com/item/1005008919369057.html) | 2 | $4.88 |
| [Dupont Cables](https://www.aliexpress.com/ssr/300000512/BundleDealsDutyCovered) | 1 kit | $2.48 |
| **Total** | | **$13.31** |

So basecly, it's much cheaper, and easyer, and it use the same firmware, with some line deleted, that you can check on the [firmware](firmware/firmware%20-%20Tiny.ino) folder.

I remove the screws and insert because now you can just clip the cover on the actual box.

Afetr that, I updated the readme with this new version, and it's all for today !

**Total time spent: 5 hours**
