GLOXIOU/DMX-Unit-DIY/(commit log)

2026-09-09 Refactor code structure for improved readability and maintainability
    [DMX Unit - V1.stl]
2026-09-09 Add cooling and assembly details for the DMX box, including fan placement and component list
2026-09-10 Revise ESP-32 wiring and 3D model details
    Updated the ESP-32 wiring diagram and 3D model with new components and changes.
2026-09-10 Update JOURNAL.md with wiring diagram and connection chart
    Added an update about the connection chart and time spent.
2026-09-10 Revise connection chart for ESP32-S3 components
    Updated the connection chart for ESP32-S3 and components, including W5500 Mini and MAX485 modules. Added detailed pin connections and configurations for better clarity.
2026-09-10 Revise fan connection details and RJ45 note
    Updated fan connection table and added note about RJ45 connector pinout.
2026-09-10 Revise Day 3 journal entry for clarity and updates
    Updated the journal entries for Day 3 to reflect ongoing work on the 3D model and wiring diagram, corrected typos, and added notes on the connection chart.
2026-09-10 Update JOURNAL.md with BOM details
    Added a note about completing the BOM with prices and links.
2026-09-11 Big update
    [40x40 Cooling Fan.STEP, DMX Unit - Cover - F.stl, DMX Unit - Cover.f3d, DMX Unit - V3.stl, DMX Unit - V4 - F.stl, DMX Unit up.f3d, DMX Unit.f3d, ESP32-S3-WROOM-1.STEP]
2026-09-12 Add BOM
    [BOM.csv]
